dlgus0630/Project07_MotorControl/artifacts/motor_model.png

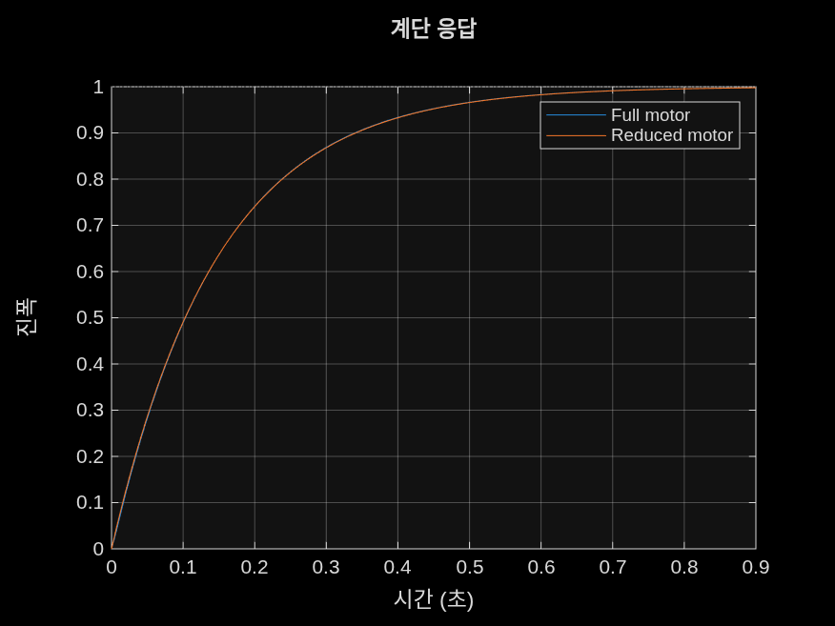
artifacts/motor_model.png
