dlgus0630/Project07_MotorControl/artifacts/pid_response.png

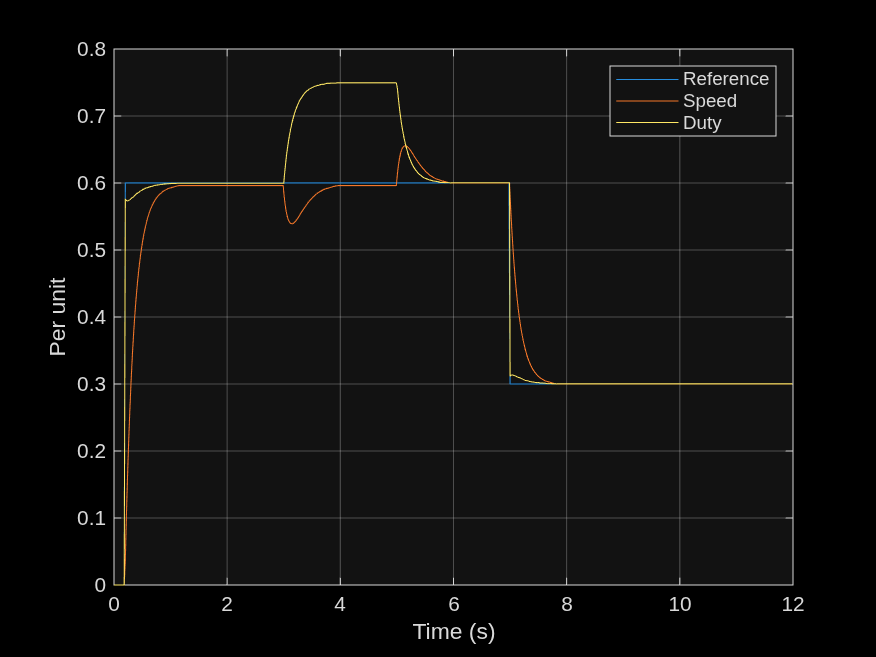
artifacts/pid_response.png
