dlgus0630/Project07_MotorControl/artifacts/experiments/hybrid_fixed_step_trial_01_response.png

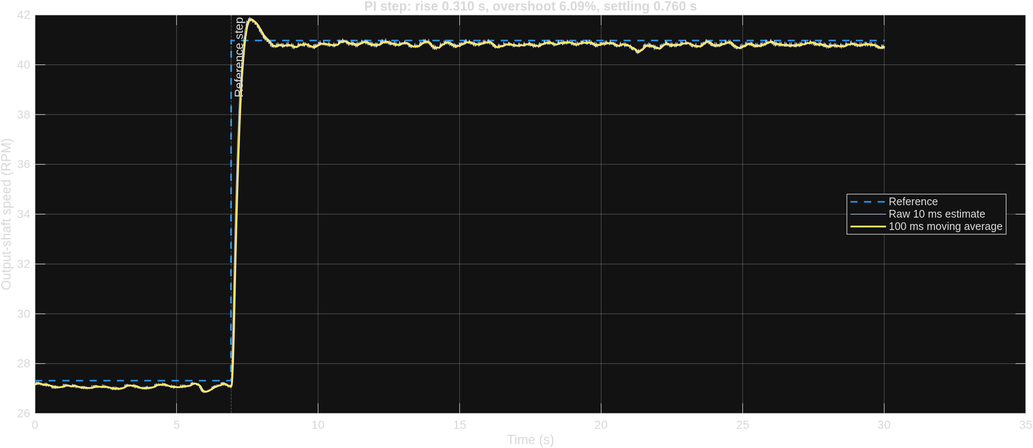
artifacts/experiments/hybrid_fixed_step_trial_01_response.png
