dlgus0630/Project07_MotorControl/laplace/constraints/basys3.xdc

# Pins cross-checked against Digilent Basys-3-Master.xdc.
set_property PACKAGE_PIN W5 [get_ports clk]
set_property IOSTANDARD LVCMOS33 [get_ports clk]
create_clock -name sys_clk -period 10 [get_ports clk]
set_property PACKAGE_PIN U18 [get_ports btnC]
set_property IOSTANDARD LVCMOS33 [get_ports btnC]
set_false_path -from [get_ports btnC]
set_property PACKAGE_PIN V17 [get_ports {sw[0]}]
set_property PACKAGE_PIN V16 [get_ports {sw[1]}]
set_property PACKAGE_PIN W16 [get_ports {sw[2]}]
set_property PACKAGE_PIN W17 [get_ports {sw[3]}]
set_property PACKAGE_PIN W15 [get_ports {sw[4]}]
set_property IOSTANDARD LVCMOS33 [get_ports {sw[*]}]
set_false_path -from [get_ports {sw[*]}]
set_property PACKAGE_PIN U16 [get_ports {led[0]}]
set_property PACKAGE_PIN E19 [get_ports {led[1]}]
set_property PACKAGE_PIN U19 [get_ports {led[2]}]
set_property PACKAGE_PIN V19 [get_ports {led[3]}]
set_property PACKAGE_PIN W18 [get_ports {led[4]}]
set_property PACKAGE_PIN U15 [get_ports {led[5]}]
set_property PACKAGE_PIN U14 [get_ports {led[6]}]
set_property PACKAGE_PIN V14 [get_ports {led[7]}]
set_property PACKAGE_PIN V13 [get_ports {led[8]}]
set_property PACKAGE_PIN V3 [get_ports {led[9]}]
set_property PACKAGE_PIN W3 [get_ports {led[10]}]
set_property PACKAGE_PIN U3 [get_ports {led[11]}]
set_property PACKAGE_PIN P3 [get_ports {led[12]}]
set_property PACKAGE_PIN N3 [get_ports {led[13]}]
set_property PACKAGE_PIN P1 [get_ports {led[14]}]
set_property PACKAGE_PIN L1 [get_ports {led[15]}]
set_property IOSTANDARD LVCMOS33 [get_ports {led[*]}]
set_property PACKAGE_PIN J1 [get_ports motor_pwm]
set_property PACKAGE_PIN L2 [get_ports motor_in1]
set_property PACKAGE_PIN J2 [get_ports motor_in2]
set_property PACKAGE_PIN G2 [get_ports encoder_a]
set_property IOSTANDARD LVCMOS33 [get_ports {motor_pwm motor_in1 motor_in2 encoder_a}]
set_property PACKAGE_PIN A18 [get_ports uart_tx]
set_property IOSTANDARD LVCMOS33 [get_ports uart_tx]
set_property PULLDOWN true [get_ports encoder_a]
set_false_path -from [get_ports encoder_a]
# LEDs and L298N controls have no external synchronous receiver clock.
set_false_path -to [get_ports {led[*] motor_pwm motor_in1 motor_in2 uart_tx}]
set_property CONFIG_VOLTAGE 3.3 [current_design]
set_property CFGBVS VCCO [current_design]
