dlgus0630/Project07_MotorControl/(commit log)

2026-09-12 Add Basys3 fixed-point PID motor controller project
    Pure RTL PID/PWM/encoder pipeline for a DC motor, MATLAB transfer-function
    Golden model, XSim regression across saturation/anti-windup/fault cases, and
    Vivado 2024.2 synthesis/bitstream in the safe internal test-plant mode.
    MATLAB and XSim (5/5) verified; DRC errors 0.
    [pid_config.json, pid_reference.csv]
2026-09-12 Document hardware wiring and project handoff
2026-09-12 Add Basys3 motor control commissioning workflow
2026-09-13 Fix hybrid encoder hysteresis glitch and validate settling-time gain
    Hardware testing found a reproducible 1-sample glitch in the hybrid
    reciprocal/window-count encoder estimator: pulse-timing jitter alone
    could push a single 10 ms window to HIGH_COUNT_THRESHOLD, causing an
    isolated jump to window_speed even in steady state. Added a two-level
    hysteresis (HIGH=14, LOW=10) so the estimator only switches modes with
    enough margin above the tested operating range, and added a regression
    test in tb_encoder_hybrid covering the fluctuation band.
    Re-verified end to end after the fix: MATLAB/Simulink PASS, full 7-test
    XSim regression PASS, Vivado synthesis/implementation/timing closure
    (setup +0.116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
    [baseline_step_summary.csv, hybrid_fixed_step_trial_01.csv, hybrid_fixed_step_trial_01_metrics.csv, hybrid_fixed_step_trial_02.csv, hybrid_fixed_step_trial_02_metrics.csv, hybrid_fixed_step_trial_03.csv, hybrid_fixed_step_trial_03_metrics.csv, hybrid_fixed_trials_summary.csv]
2026-09-14 Correct the status table and report the final implementation numbers
    The status table still said the UART telemetry unit test was waiting for a
    full regression, which the 7-test XSim run had already covered, and the
    prose labelled the pre-telemetry closed-loop build as the final one.
    - XSim row now states 7 passing testbenches including tb_encoder_hybrid
    - the intermediate closed-loop build (+0.060 ns setup, LUT 450, FF 416) is
    named as intermediate
    - the final hysteresis-fix build is reported from its own reports:
    setup +0.116 ns, hold +0.093 ns, DRC Error 0, LUT 741, FF 791, DSP 4
2026-09-15 Record this repo's new role: development baseline for Zybo integration
    This repo is no longer the target for the final physical system. On
    2026-09-15 the plan changed to porting the encoder hybrid estimator and PI
    controller into Project07_VibrationNPU's Zybo PL so the whole system runs
    on one board, instead of keeping the two boards as separate demonstrations.
    This repo is not deleted; it stays as the preserved, independently
    verified controller-development baseline and the comparison point for the
    integrated system. The 12-9-12 V disturbance test, the 5x step-response
    repeat, open-loop identification, and C2 quadrature work move to the Zybo
    repo and are not repeated here.
